develmusa/Thermomine/marketing/02_glance_blue.png

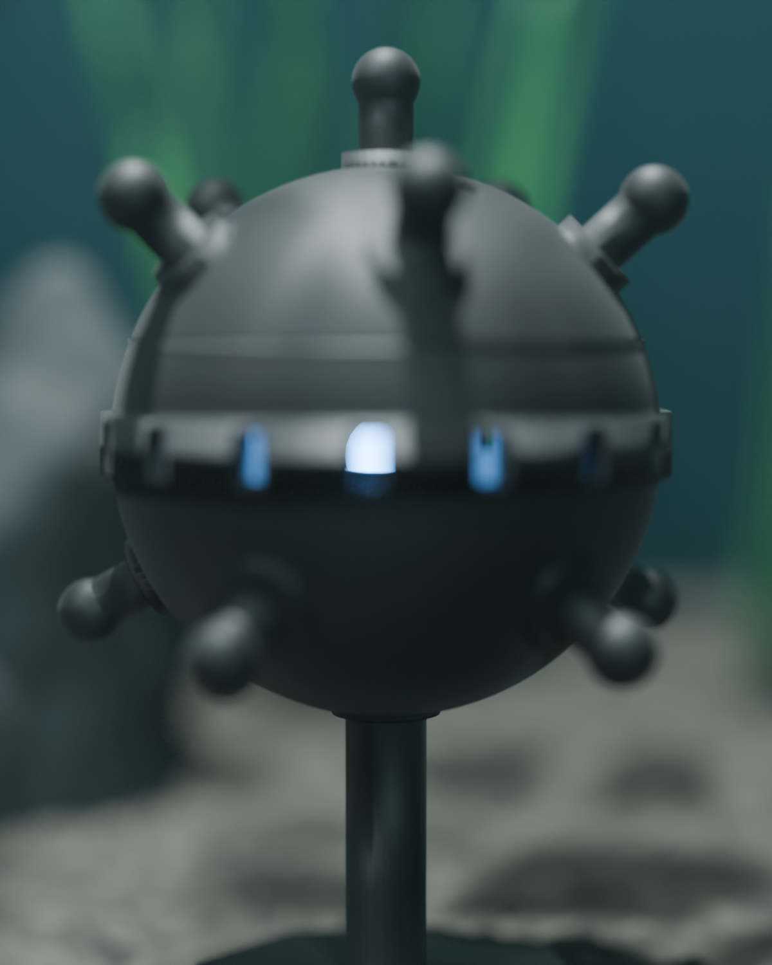
marketing/02_glance_blue.png
