develmusa/Thermomine/marketing/concepts/1_warning_red.png

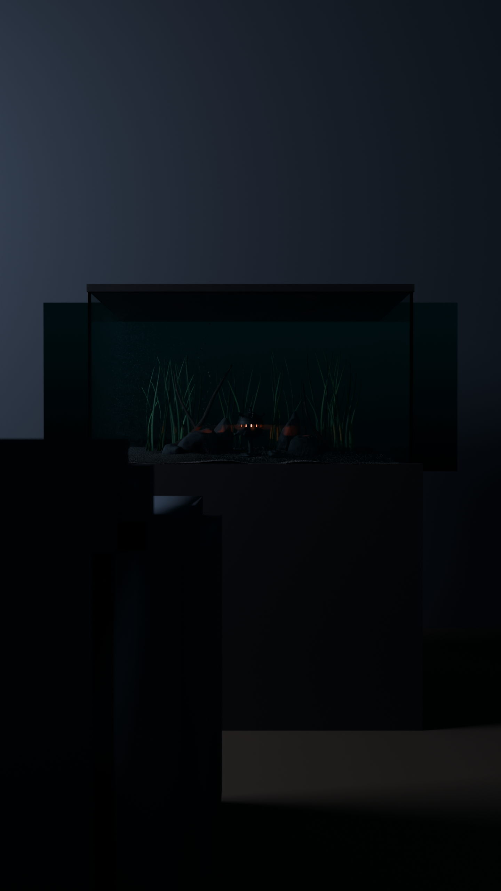
marketing/concepts/1_warning_red.png
