develmusa/Thermomine/marketing/concepts/2_aesthetic_tank.png

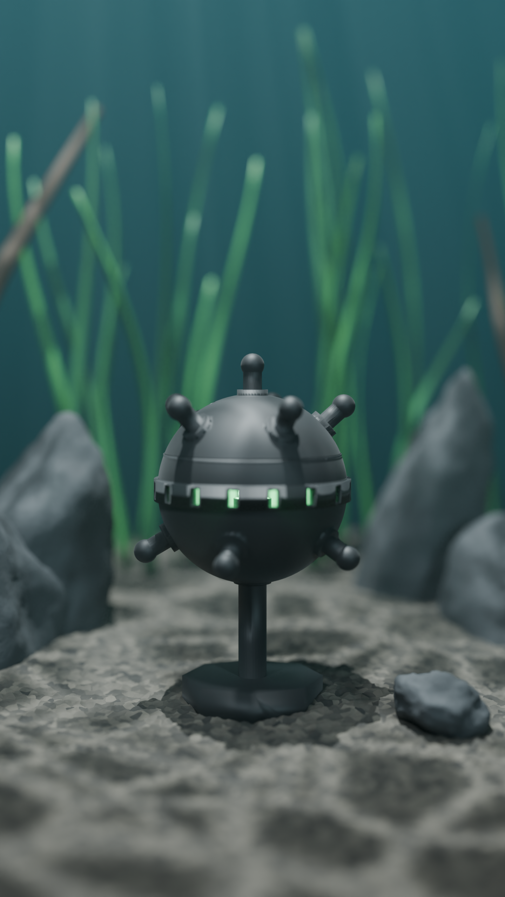
marketing/concepts/2_aesthetic_tank.png
