develmusa/Thermomine/marketing/concepts/4_asmr_macro.png

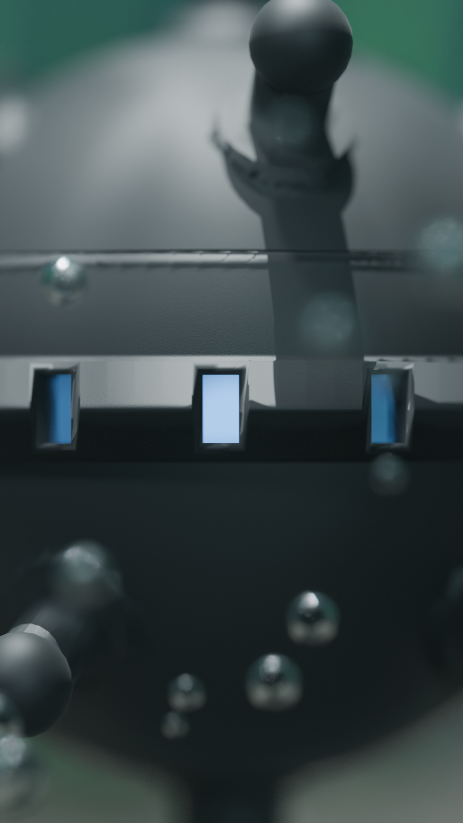
marketing/concepts/4_asmr_macro.png
