develmusa/Thermomine/marketing/concepts/6_shipwreck_theme.png

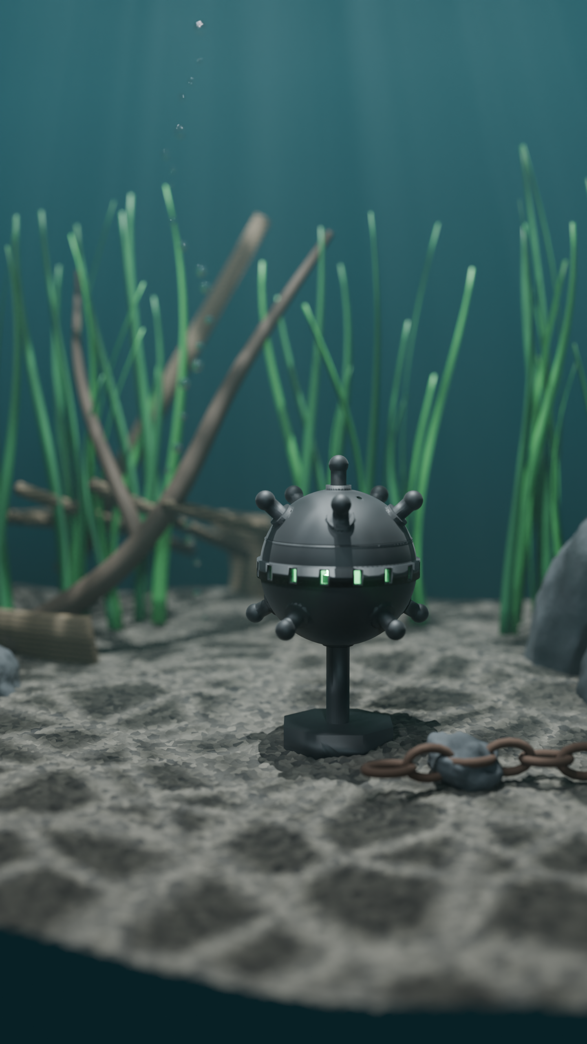
marketing/concepts/6_shipwreck_theme.png
