develmusa/Thermomine/marketing/tiktok/tiktok_first_frame.jpg

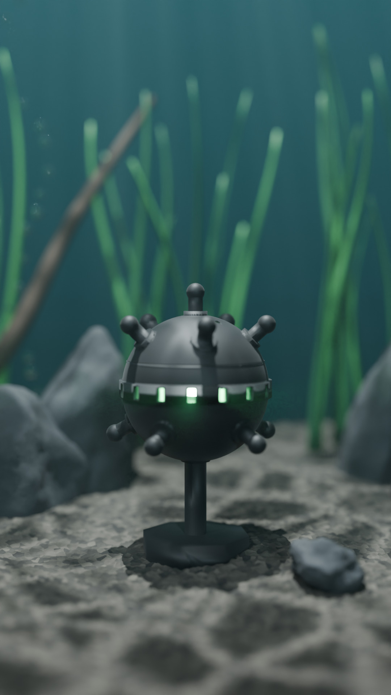
marketing/tiktok/tiktok_first_frame.jpg
