develmusa/Thermomine/pcb/preview/board_bottom_3d.png

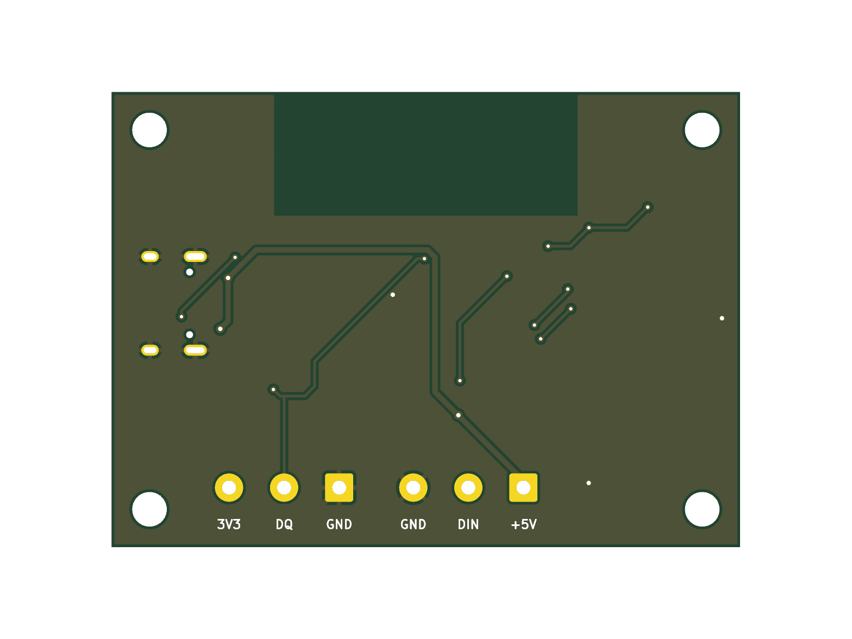
pcb/preview/board_bottom_3d.png
