develmusa/Thermomine/pcb/preview/board_populated_3q.png

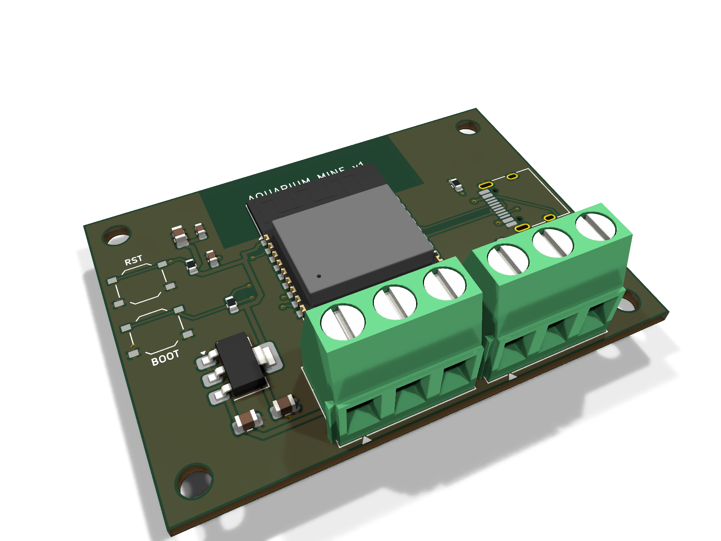
pcb/preview/board_populated_3q.png
