develmusa/Thermomine/pcb/preview/board_populated_top.png

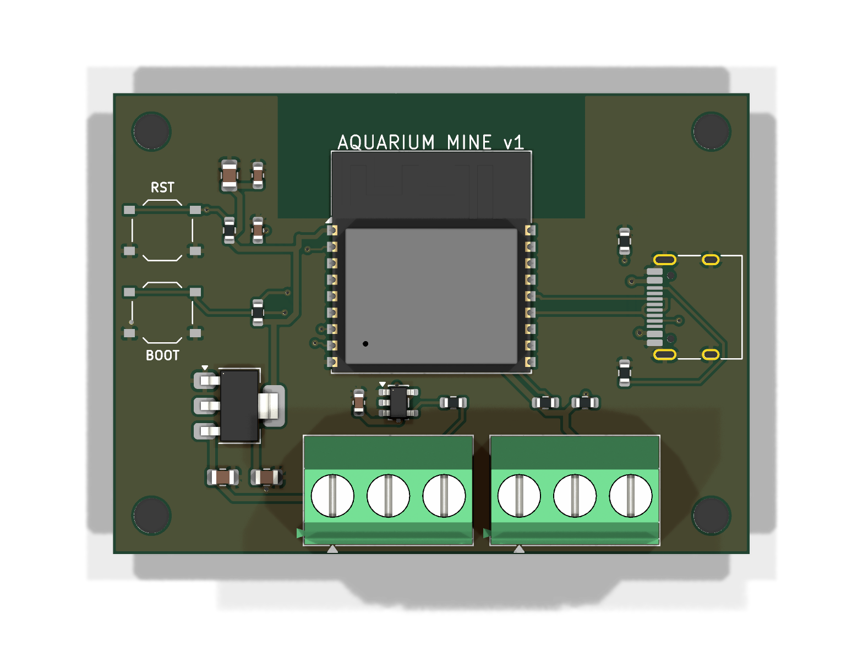
pcb/preview/board_populated_top.png
