develmusa/Thermomine/pcb/preview/board_top_3d.png

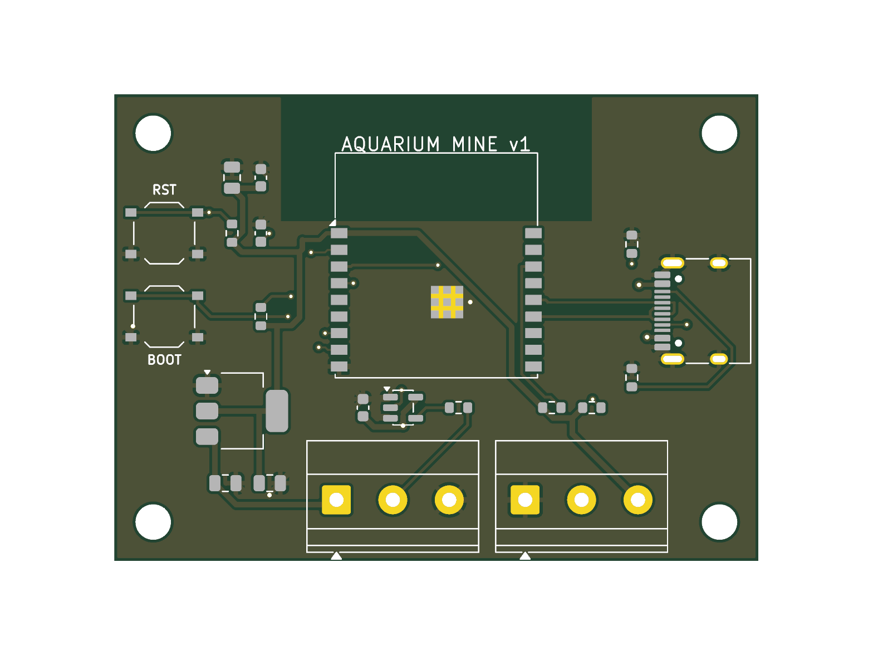
pcb/preview/board_top_3d.png
