develmusa/Thermomine/underwater_minefield.png

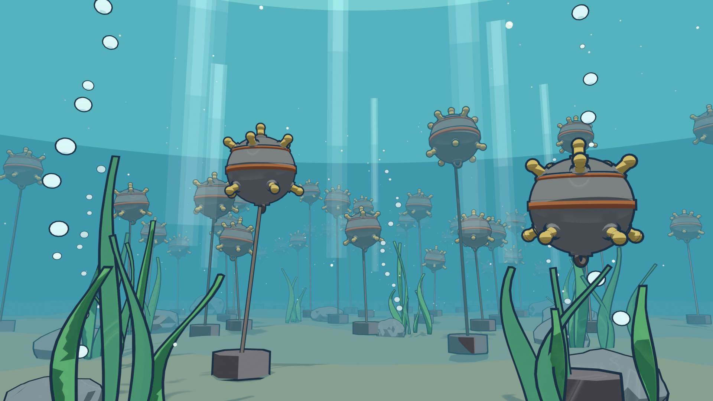
underwater_minefield.png
