develmusa/Thermomine/pcb/fab/aquarium_mine_ctrl_bom.csv

Comment | Designator | Footprint | Quantity | Manufacturer Part | LCSC Part #
ESP32-C3-WROOM-02-N4 | U1 | ESP32-C3-WROOM-02 | 1 | ESP32-C3-WROOM-02-N4 | C2934560
USB-C | J1 | USB_C_Receptacle_HRO_TYPE-C-31-M-12 | 1 | TYPE-C-31-M-12 | C165948
AMS1117-3.3 | U2 | SOT-223-3_TabPin2 | 1 | AMS1117-3.3 | C6186
74AHCT1G125 | U3 | SOT-23-5 | 1 | 74AHCT1G125DBVTG4 | C2870384
KF301-5.0-3P | J2,J3 | TerminalBlock_Phoenix_MKDS-1,5-3-5.08_1x03_P5.08mm_Horizontal | 2 | KF301-5.0-3P | C474882
TS-1187A-B-A-B | SW1,SW2 | SW_Push_1P1T_XKB_TS-1187A | 2 | TS-1187A-B-A-B | C318884
10uF | C1,C3 | C_0805_2012Metric | 2 | CL21A106KAYNNNE | C15850
22uF | C2 | C_0805_2012Metric | 1 | CL21A226MAQNNNE | C45783
100nF | C4,C6 | C_0603_1608Metric | 2 | CC0603KRX7R9BB104 | C14663
1uF | C5 | C_0603_1608Metric | 1 | CL10A105KB8NNNC | C15849
10k | R1,R2,R3 | R_0603_1608Metric | 3 | 0603WAF1002T5E | C25804
5.1k | R4,R5 | R_0603_1608Metric | 2 | 0603WAF5101T5E | C23186
4.7k | R6 | R_0603_1608Metric | 1 | 0603WAF4701T5E | C23162
330 | R7 | R_0603_1608Metric | 1 | 0603WAF3300T5E | C23138
