develmusa/Thermomine/print/mine_assembly.step

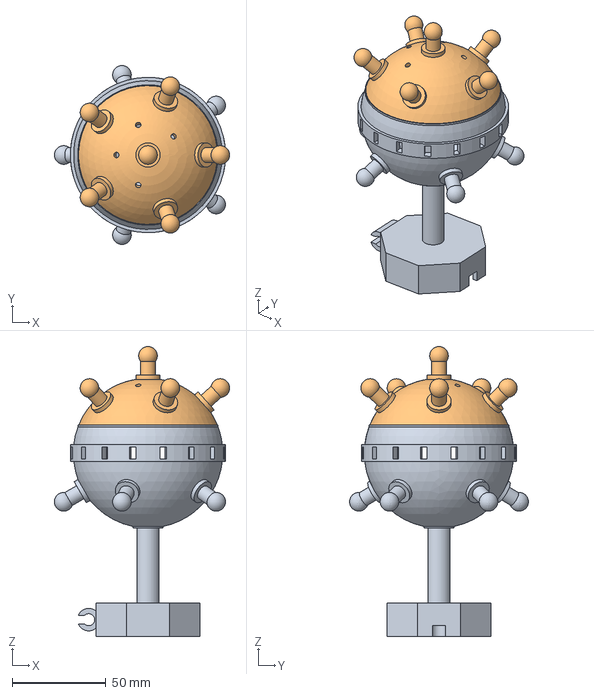
[picture p24: CAD file, 2026-10-26]
print/mine_assembly.step
93.7 x 95.6 x 155.0 mm
