develmusa/Thermomine/print/mine_cap.step

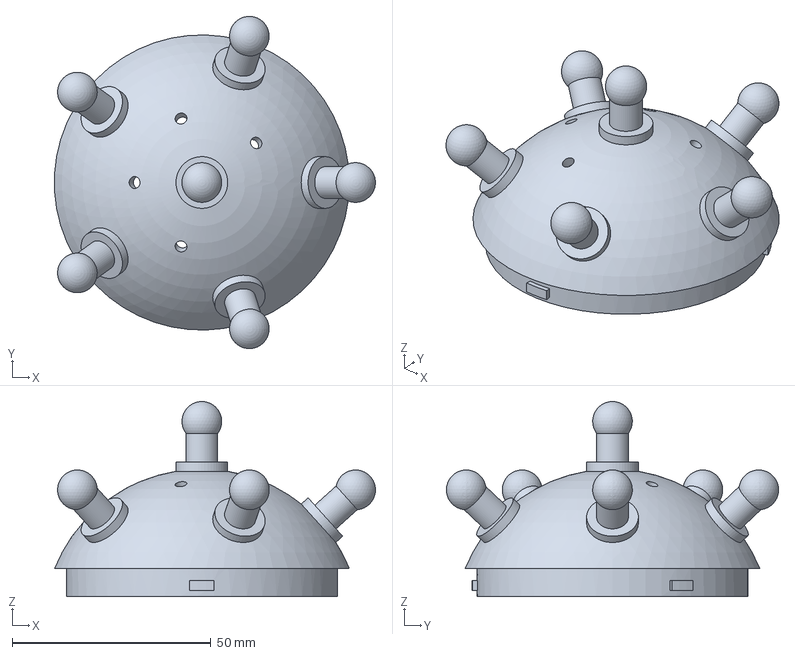
[picture p25: CAD file, 2026-10-26]
print/mine_cap.step
80.7 x 83.5 x 49.0 mm
