develmusa/Thermomine/print/mine_bottom.step

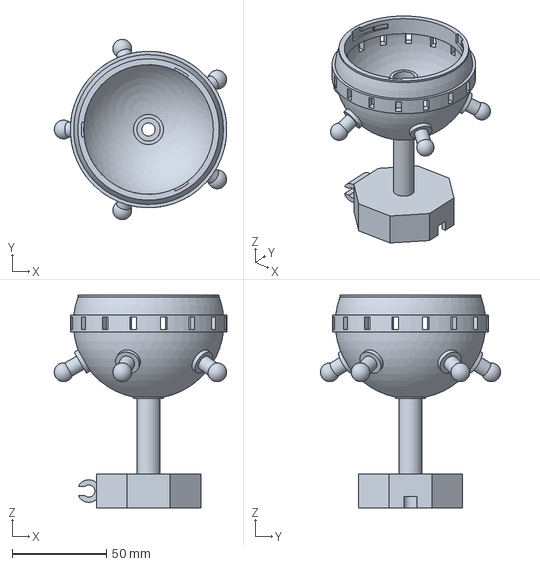
[picture p26: CAD file, 2026-10-26]
print/mine_bottom.step
91.5 x 95.6 x 113.0 mm
