develmusa/Thermomine/print/mine_print_plate.3mf

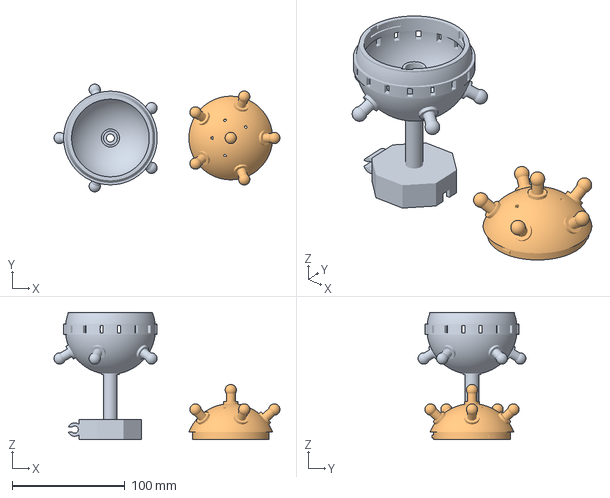
[picture p27: CAD file, 2026-10-26]
print/mine_print_plate.3mf
200.4 x 95.7 x 113.0 mm
