develmusa/Thermomine/(list of files, cad)

Other CAD files:
marketing/marketing_scenes.blend
print/mine_bottom.3mf
print/mine_bottom.stl
print/mine_cap.3mf
print/mine_cap.stl
