develmusa/Thermomine/print/drawings/Thermomine_TM-001-01_bottom.pdf

⌀83

A–A

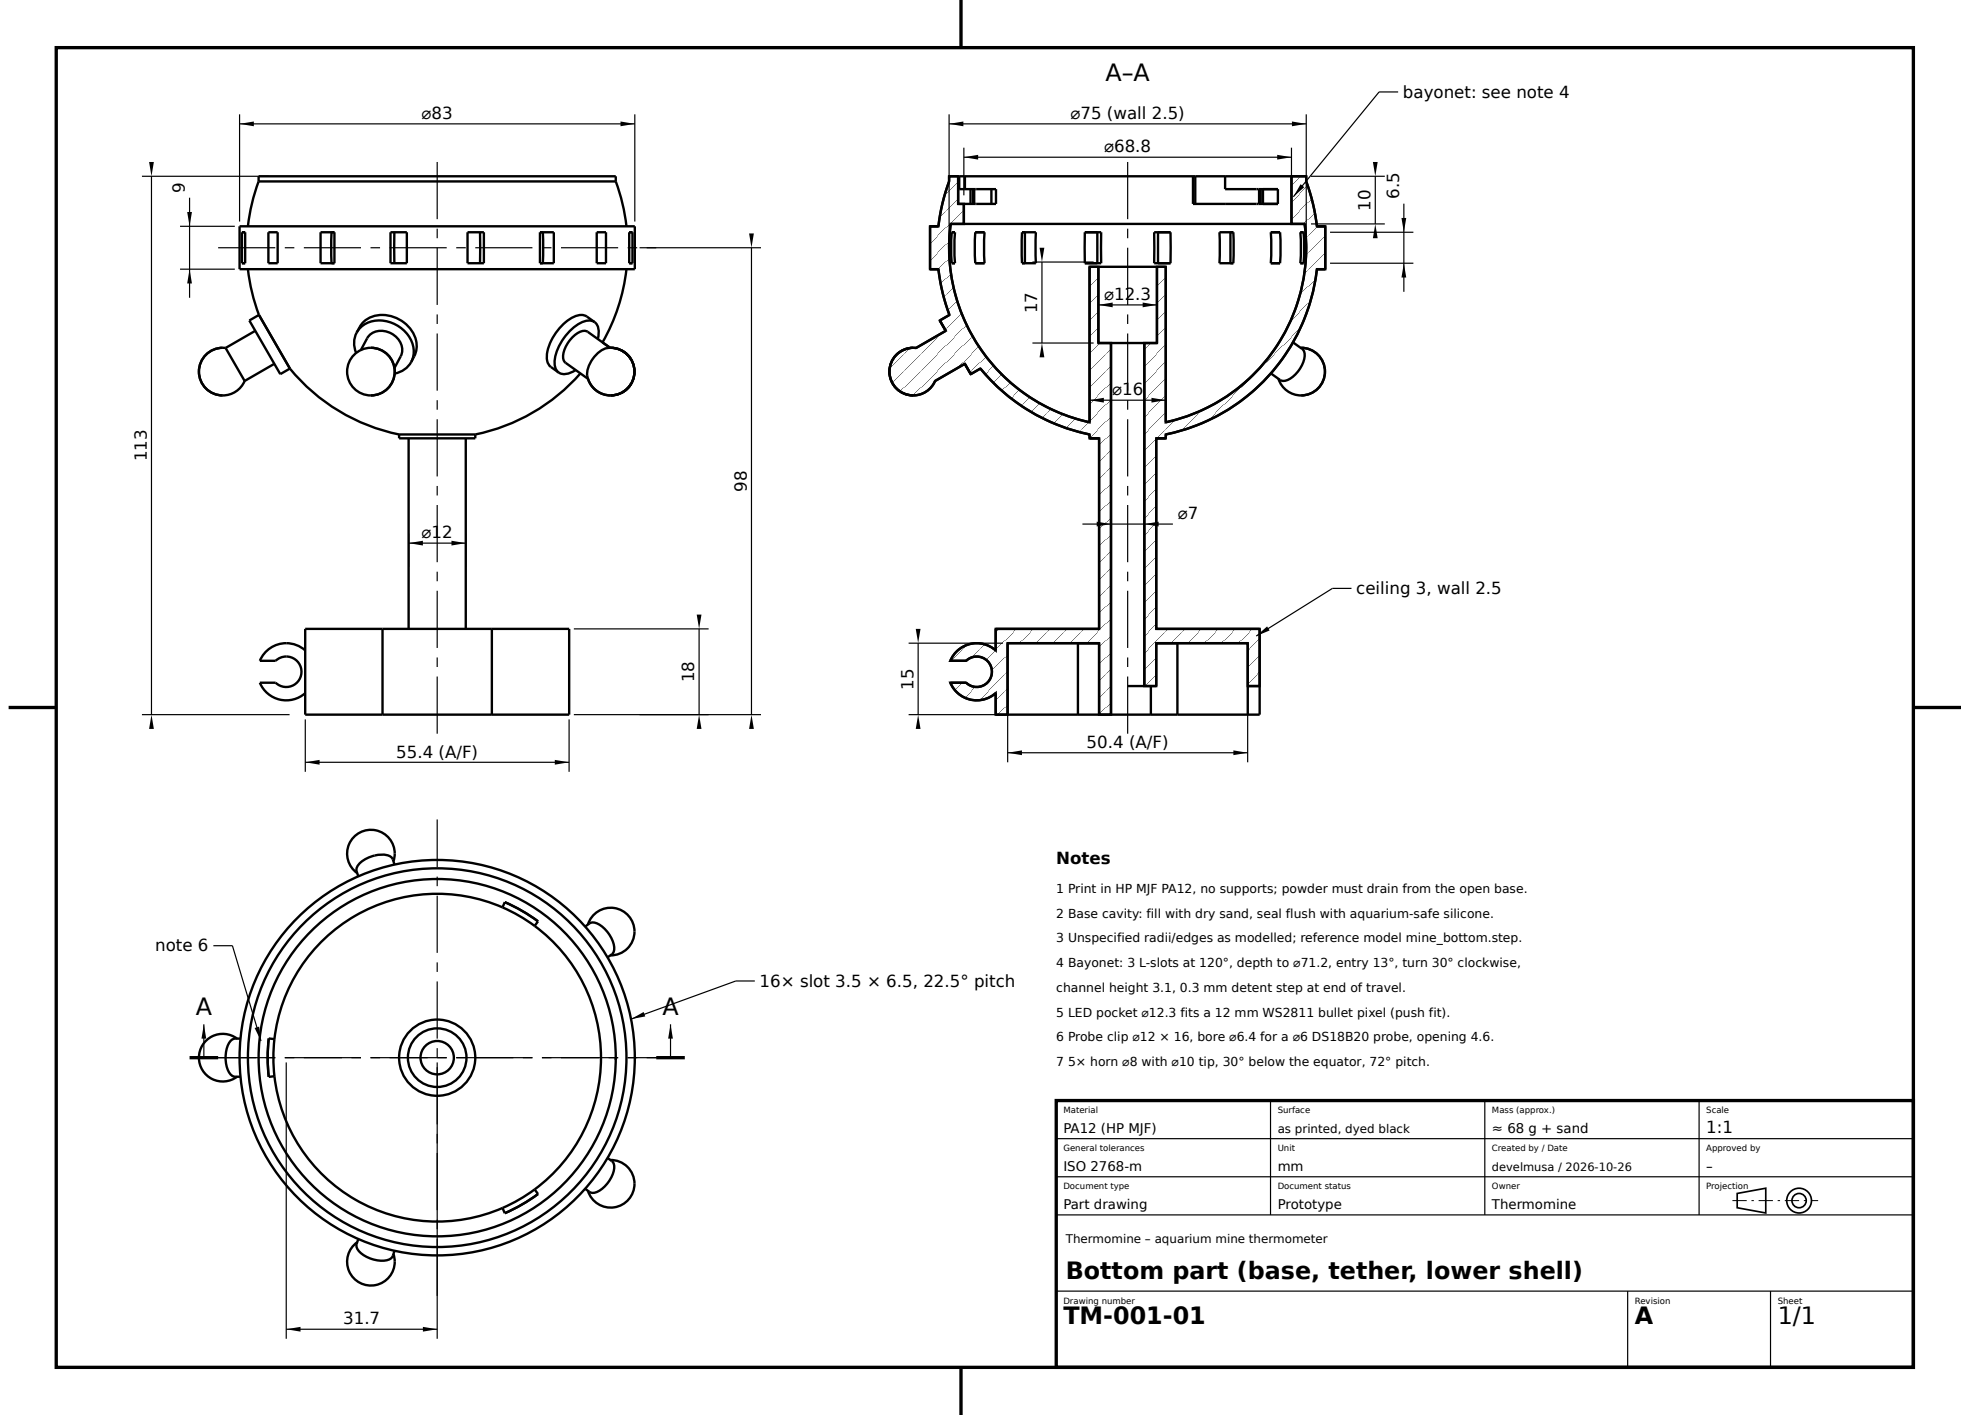
[picture p28: page 1]
16× slot 3.5 × 6.5, 22.5° pitch; note 6; ⌀75 (wall 2.5); ceiling 3, wall 2.5; Material PA12 (HP MJF); Mass (approx.) ≈ 68 g + sand; Scale 1:1; General tolerances ISO 2768-m; Unit mm; Approved by –; Document type Part drawing; Document status Prototype; Owner Thermomine; Projection; Drawing number; Revision; A Sheet 1/1; Notes

bayonet: see note 4

1 Print in HP MJF PA12, no supports; powder must drain from the open base.
2 Base cavity: fill with dry sand, seal flush with aquarium-safe silicone.
3 Unspecified radii/edges as modelled; reference model mine_bottom.step.
4 Bayonet: 3 L-slots at 120°, depth to ⌀71.2, entry 13°, turn 30° clockwise,
channel height 3.1, 0.3 mm detent step at end of travel.
5 LED pocket ⌀12.3 fits a 12 mm WS2811 bullet pixel (push fit).
6 Probe clip ⌀12 × 16, bore ⌀6.4 for a ⌀6 DS18B20 probe, opening 4.6.
7 5× horn ⌀8 with ⌀10 tip, 30° below the equator, 72° pitch.

Surface
as printed, dyed black

Created by / Date
develmusa / 2026-10-26

Thermomine – aquarium mine thermometer
Bottom part (base, tether, lower shell)
