develmusa/Thermomine/print/drawings/Thermomine_TM-001-02_cap.pdf

## 6× horn ⌀8, tip ⌀10

A–A

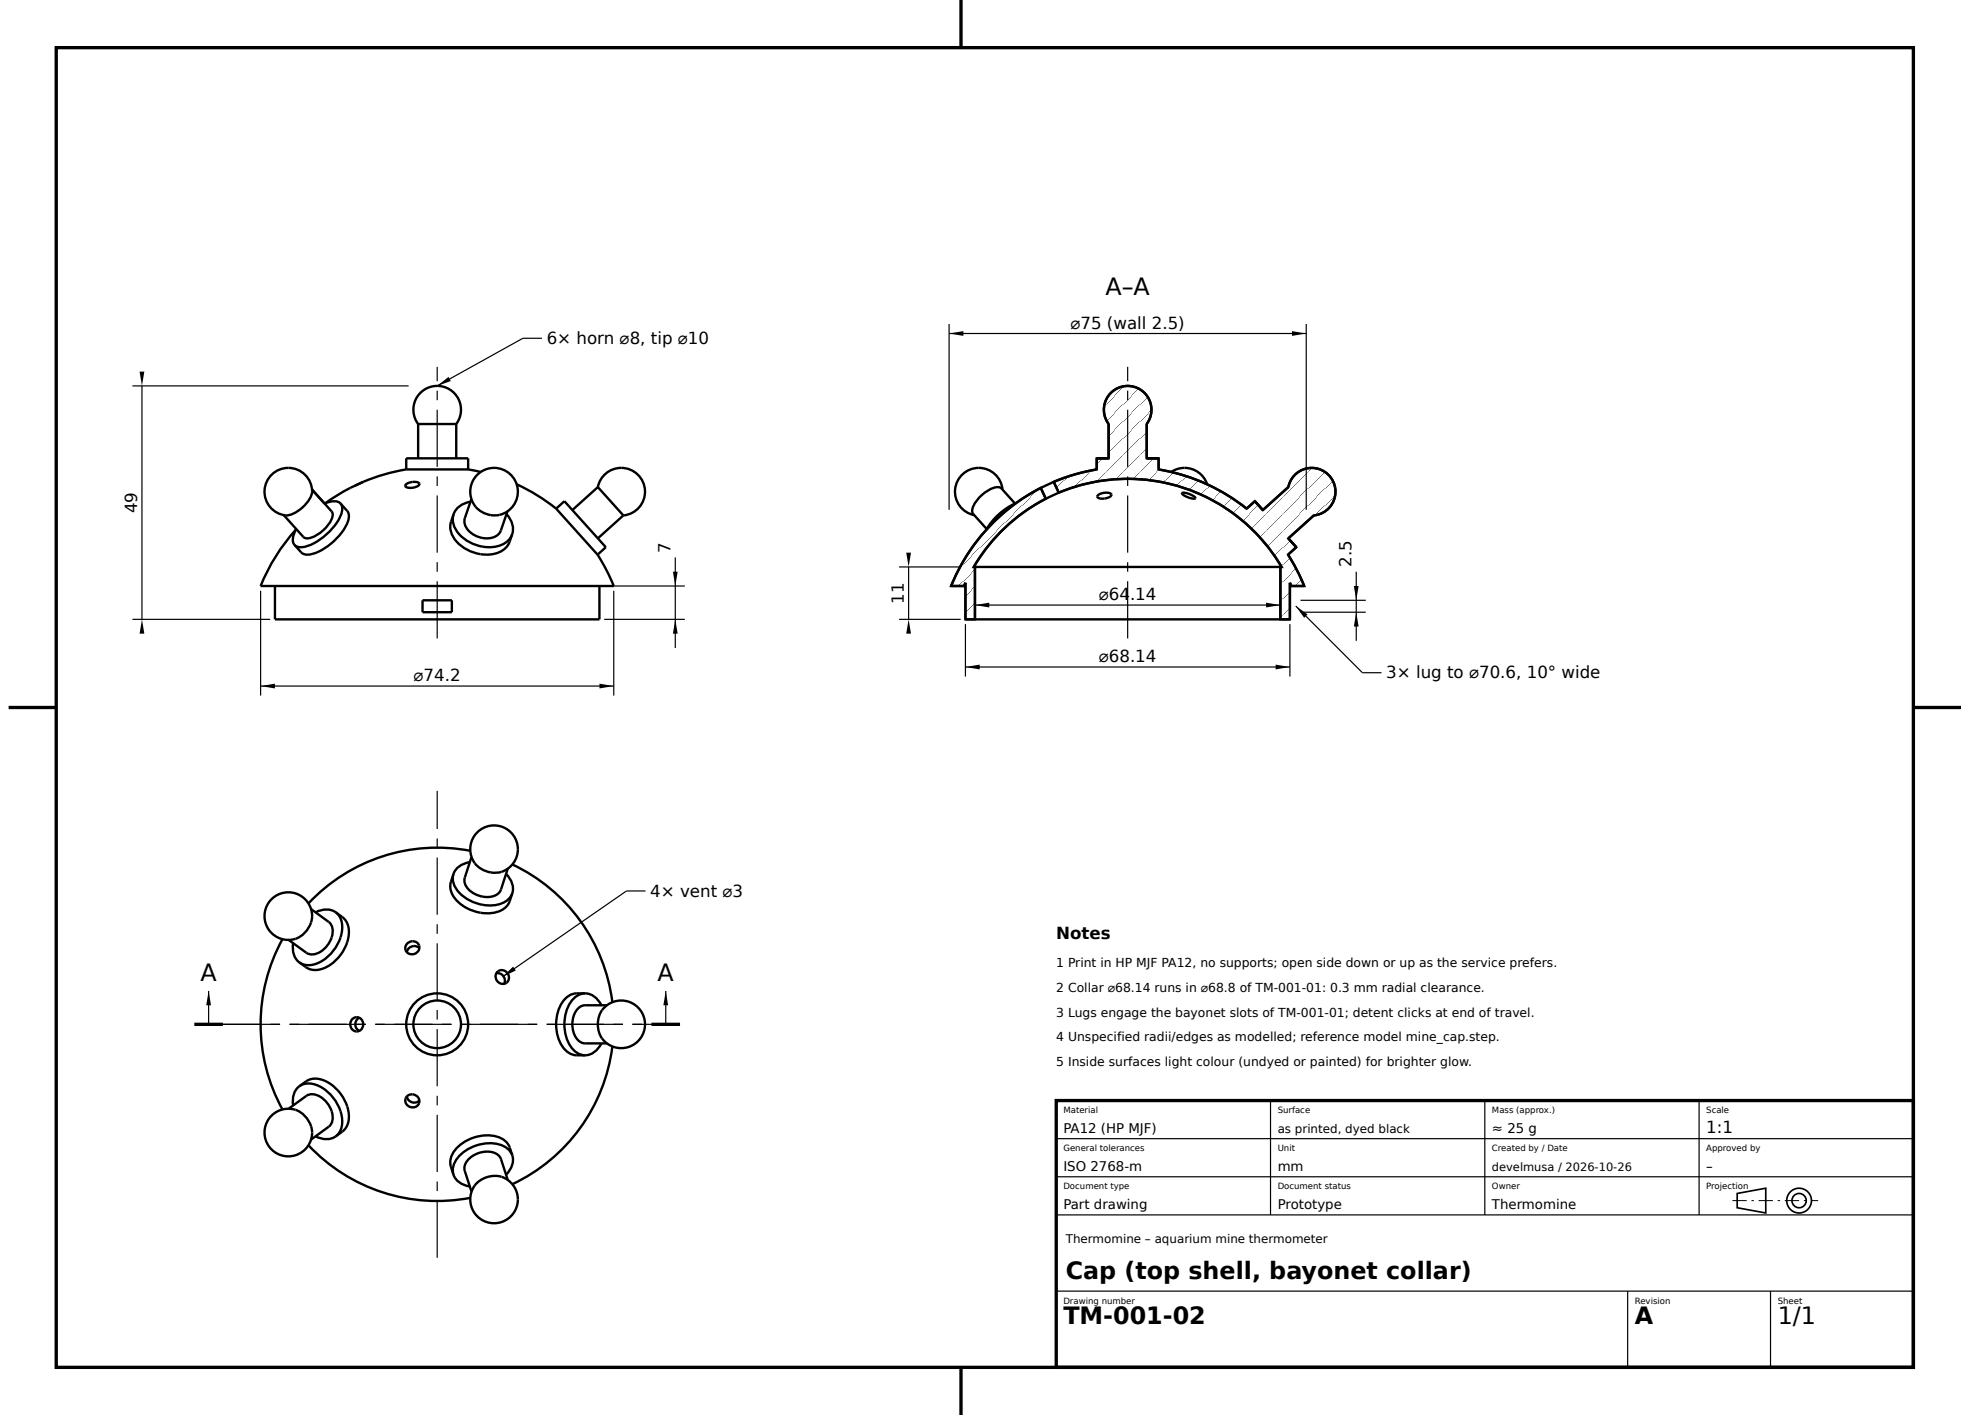
[picture p29: page 1]
4× vent ⌀3; ⌀75 (wall 2.5); Material PA12 (HP MJF); Mass (approx.) ≈ 25 g; Scale 1:1; General tolerances ISO 2768-m; Unit mm; Approved by –; Document type Part drawing; Document status Prototype; Owner Thermomine; Projection; Drawing number; Revision; A Sheet 1/1; Notes

3× lug to ⌀70.6, 10° wide

1 Print in HP MJF PA12, no supports; open side down or up as the service prefers.
2 Collar ⌀68.14 runs in ⌀68.8 of TM-001-01: 0.3 mm radial clearance.
3 Lugs engage the bayonet slots of TM-001-01; detent clicks at end of travel.
4 Unspecified radii/edges as modelled; reference model mine_cap.step.
5 Inside surfaces light colour (undyed or painted) for brighter glow.

Surface
as printed, dyed black

Created by / Date
develmusa / 2026-10-26

Thermomine – aquarium mine thermometer
Cap (top shell, bayonet collar)
