develmusa/Thermomine/pcb/aquarium_mine_ctrl.kicad_pcb

## KiCad design pcb/aquarium_mine_ctrl.kicad_pcb (2026-10-26)

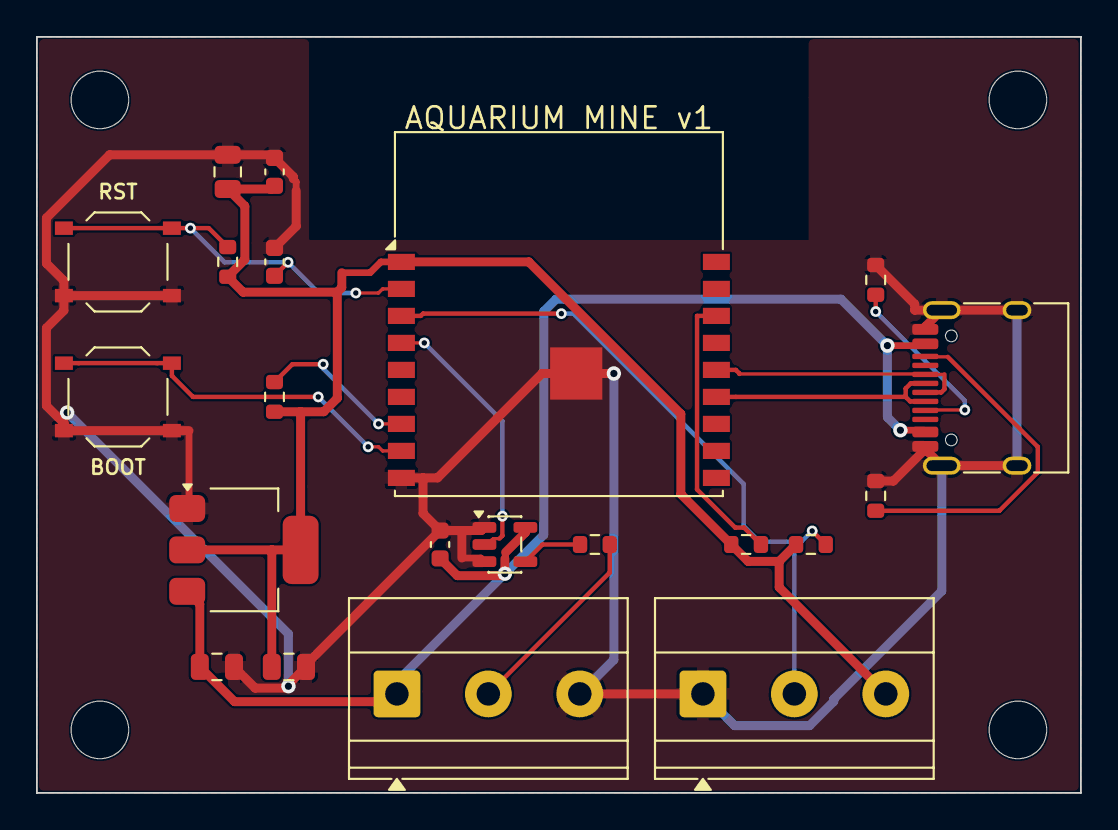
[picture p30: board aquarium_mine_ctrl.kicad_pcb from above]

Board: 2 copper layers, 58.0 x 42.0 mm, 25 parts (0 on the bottom side), 15 nets.

Parts:
C1, C3: 10uF; C_0805_2012Metric
C2: 22uF; C_0805_2012Metric
C4, C6: 100nF; C_0603_1608Metric
C5: 1uF; C_0603_1608Metric
H1, H2, H3, H4: M3; MountingHole_3.2mm_M3
J1: USB-C; USB_C_Receptacle_HRO_TYPE-C-31-M-12
J2: LED +5V/DIN/GND; TerminalBlock_Phoenix_MKDS-1,5-3-5.08_1x03_P5.08mm_Horizont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
J3: PROBE GND/DQ/3V3; TerminalBlock_Phoenix_MKDS-1,5-3-5.08_1x03_P5.08mm_Horizont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
R1, R2, R3: 10k; R_0603_1608Metric
R4, R5: 5.1k; R_0603_1608Metric
R6: 4.7k; R_0603_1608Metric
R7: 330; R_0603_1608Metric
SW1: RESET; SW_Push_1P1T_XKB_TS-1187A
SW2: BOOT; SW_Push_1P1T_XKB_TS-1187A
U1: ESP32-C3-WROOM-02-N4; ESP32-C3-WROOM-02
U2: AMS1117-3.3; SOT-223-3_TabPin2
U3: 74AHCT1G125; SOT-23-5

Connections:
+3V3: C2.1, C3.1, C4.1, J3.3, R1.1, R2.1, R3.1, R6.1, U1.1, U2.2
CC1: J1.A5, R4.1
CC2: J1.B5, R5.1
EN: C5.1, R1.2, SW1.1, U1.2
GND: C1.2, C2.2, C3.2, C4.2, C5.2, C6.2, J1.A1, J1.A12, J1.B1, J1.B12, J1.SH, J2.3, J3.1, R4.2, R5.2, SW1.2, SW2.2, U1.9, U1.19, U2.1, U3.1, U3.3
IO2: R2.2, U1.16
IO8: R3.2, U1.7
IO9: SW2.1, U1.8
LED_3V3: U1.4, U3.2
LED_5V: R7.1, U3.4
LED_DIN: J2.2, R7.2
TEMP_DQ: J3.2, R6.2, U1.3
USB_DM: J1.A7, J1.B7, U1.13
USB_DP: J1.A6, J1.B6, U1.14
VBUS: C1.1, C6.1, J1.A4, J1.A9, J1.B4, J1.B9, J2.1, U2.3, U3.5
